mamama1/DL500_Hardware/Frontpanel/R1.0/Frontpanel_Left.stl

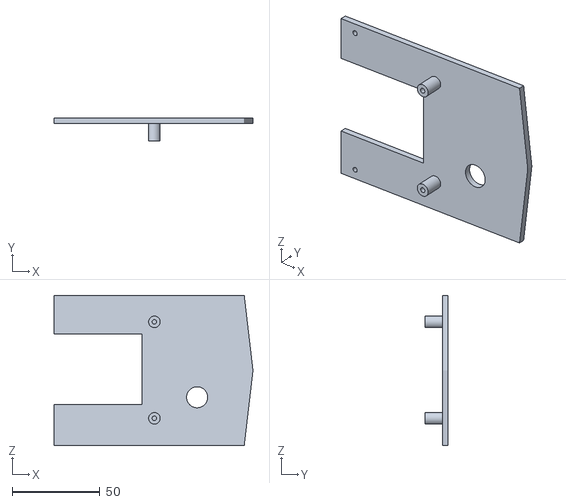
[picture p1: CAD file, 2021-10-21]
Frontpanel/R1.0/Frontpanel_Left.stl
113.5 x 13.0 x 85.6
