mamama1/DL500_Hardware/Frontpanel/R1.1/Frontpanel.stl

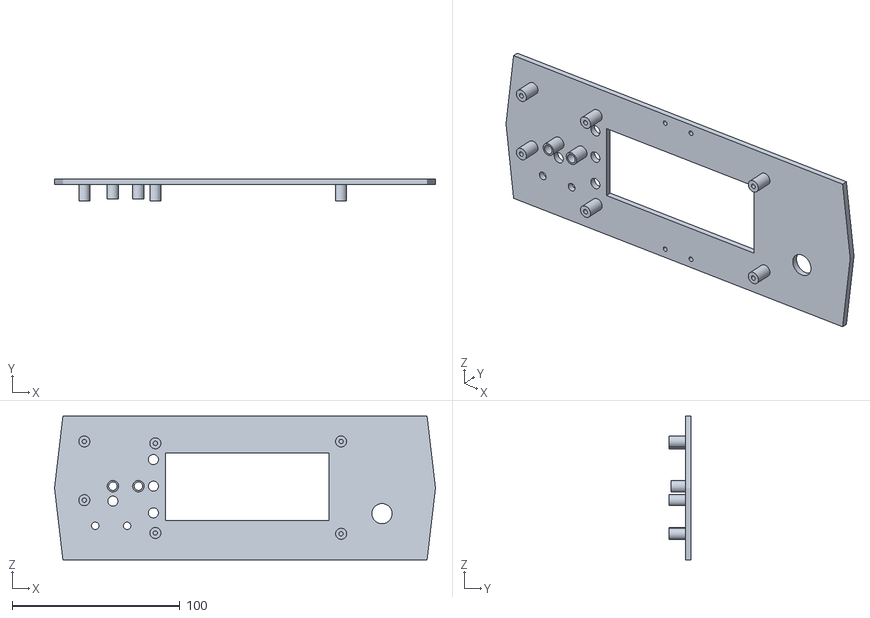
[picture p2: CAD file, 2021-10-21]
Frontpanel/R1.1/Frontpanel.stl
227.0 x 13.0 x 85.6
