mamama1/DL500_Hardware/STL/front_panel_DummyLoad_R1.0_565-6883.stl

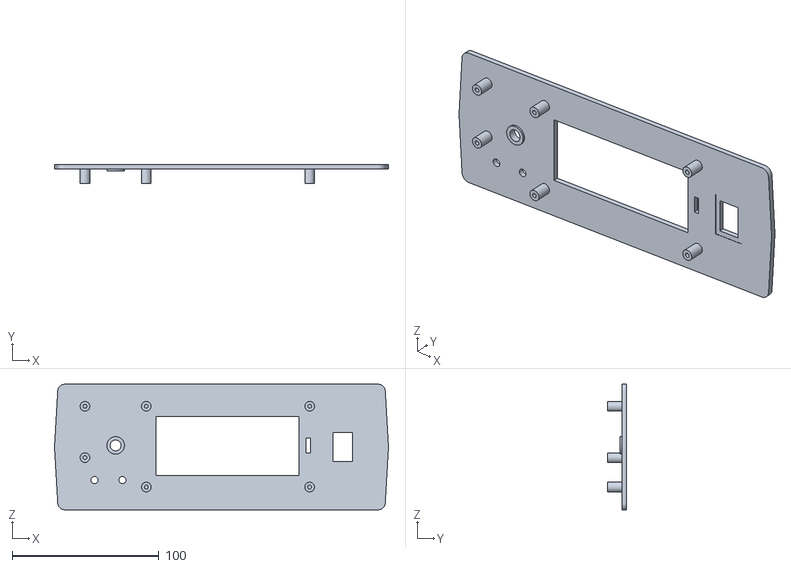
[picture p3: CAD file, 2021-10-21]
STL/front_panel_DummyLoad_R1.0_565-6883.stl
227.4 x 13.0 x 85.6
