mamama1/DL500_Hardware/Frontpanel/R1.1/Frontpanel_Right.stl

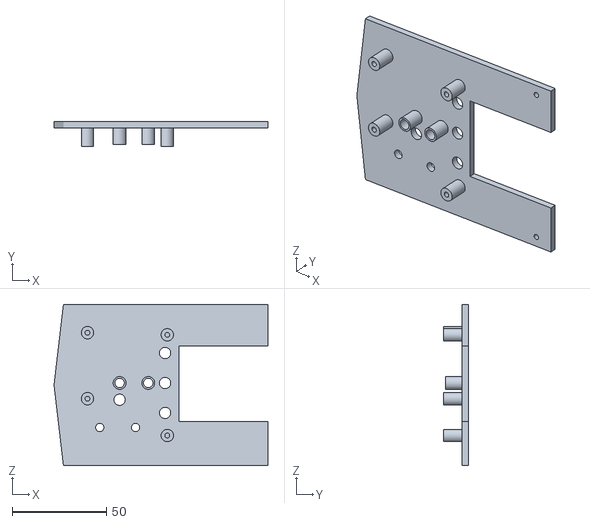
[picture p4: CAD file, 2021-10-21]
Frontpanel/R1.1/Frontpanel_Right.stl
113.5 x 13.0 x 85.6
