mamama1/DL500_Hardware/STL/back_panel_DummyLoad_R1.0.stl

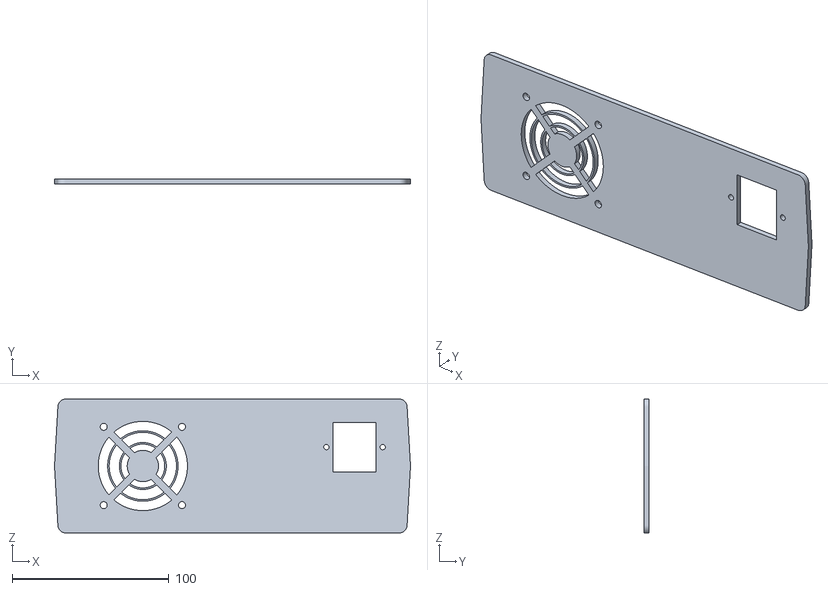
[picture p5: CAD file, 2021-10-21]
STL/back_panel_DummyLoad_R1.0.stl
227.4 x 3.20 x 85.6
