mamama1/DL500_Hardware/DummyLoad.pdf

# 32mA/T

PT 4.5/2/8 | 630 mA/T | DF04M

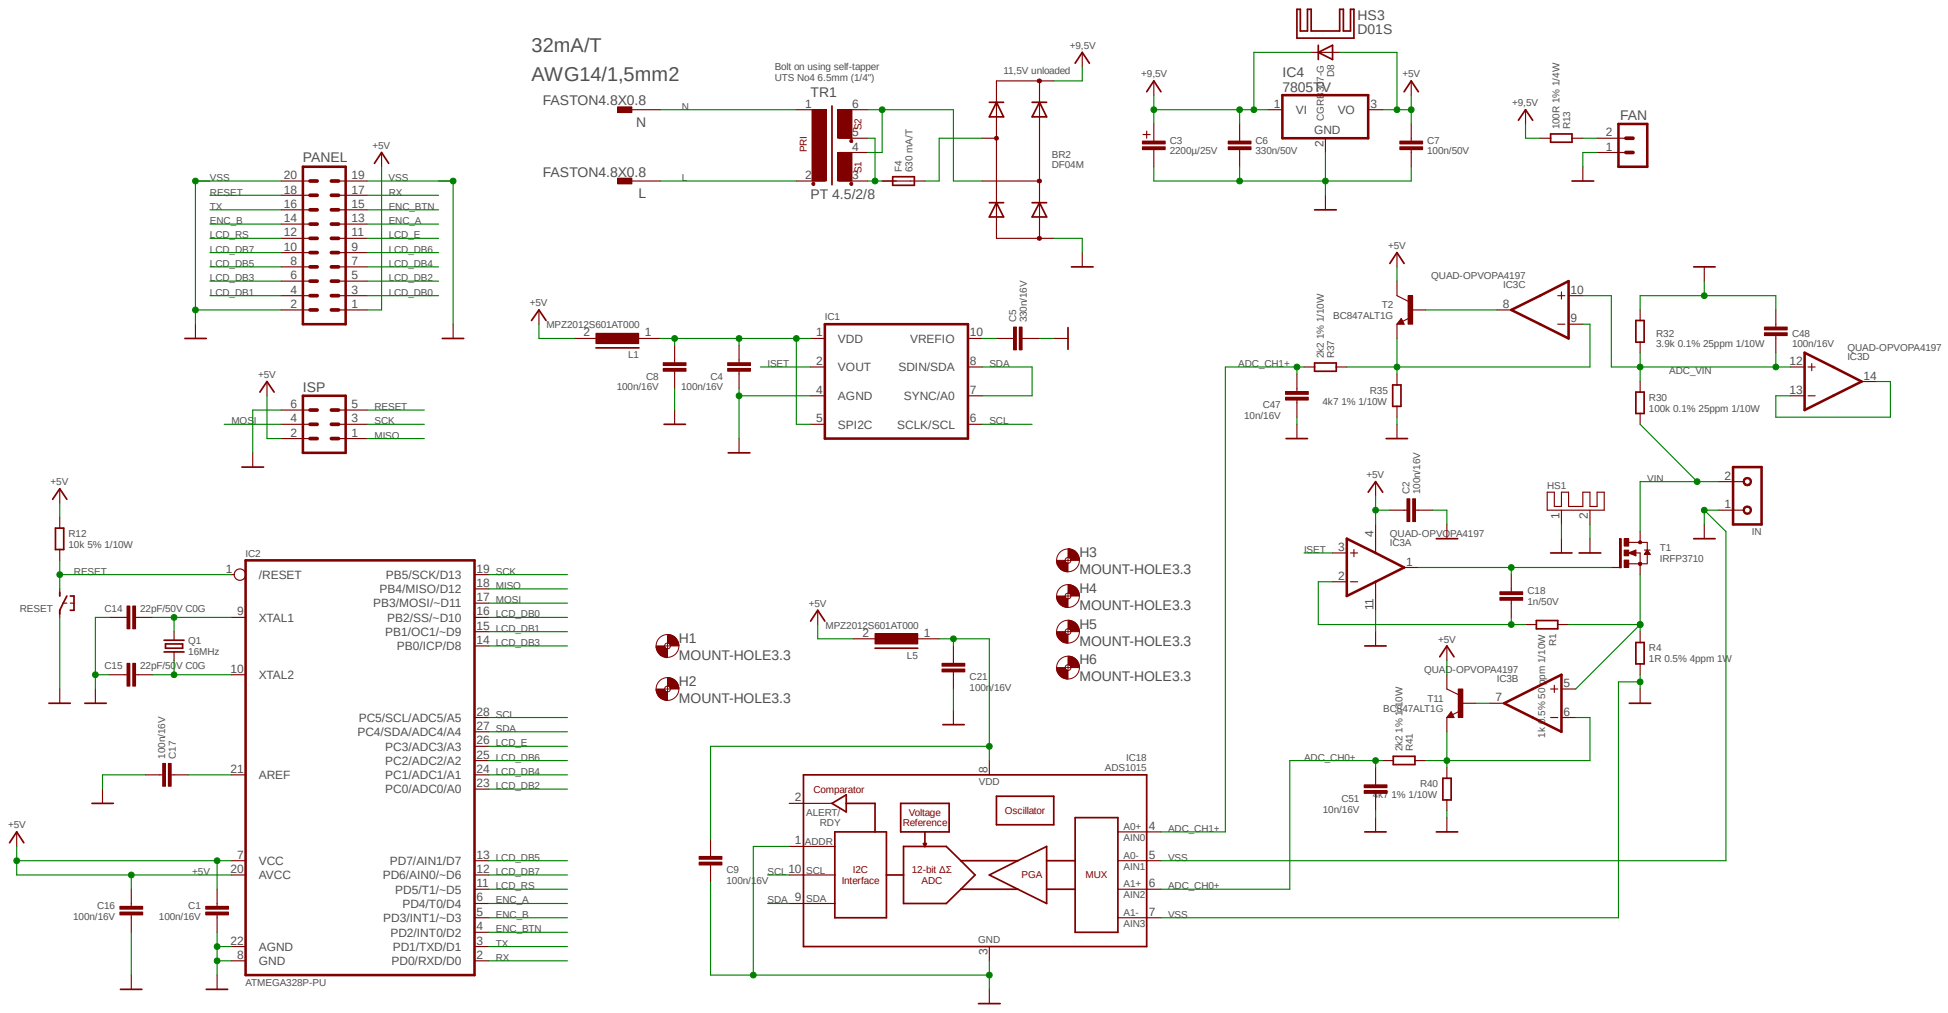
[picture p6: page 1]

Comparator

I2C Interface | AIN0 A0- | 5 VSS
