mamama1/DL500_Hardware/R1.2/DummyLoad.brd

## EAGLE design R1.2/DummyLoad.brd (2021-11-23)

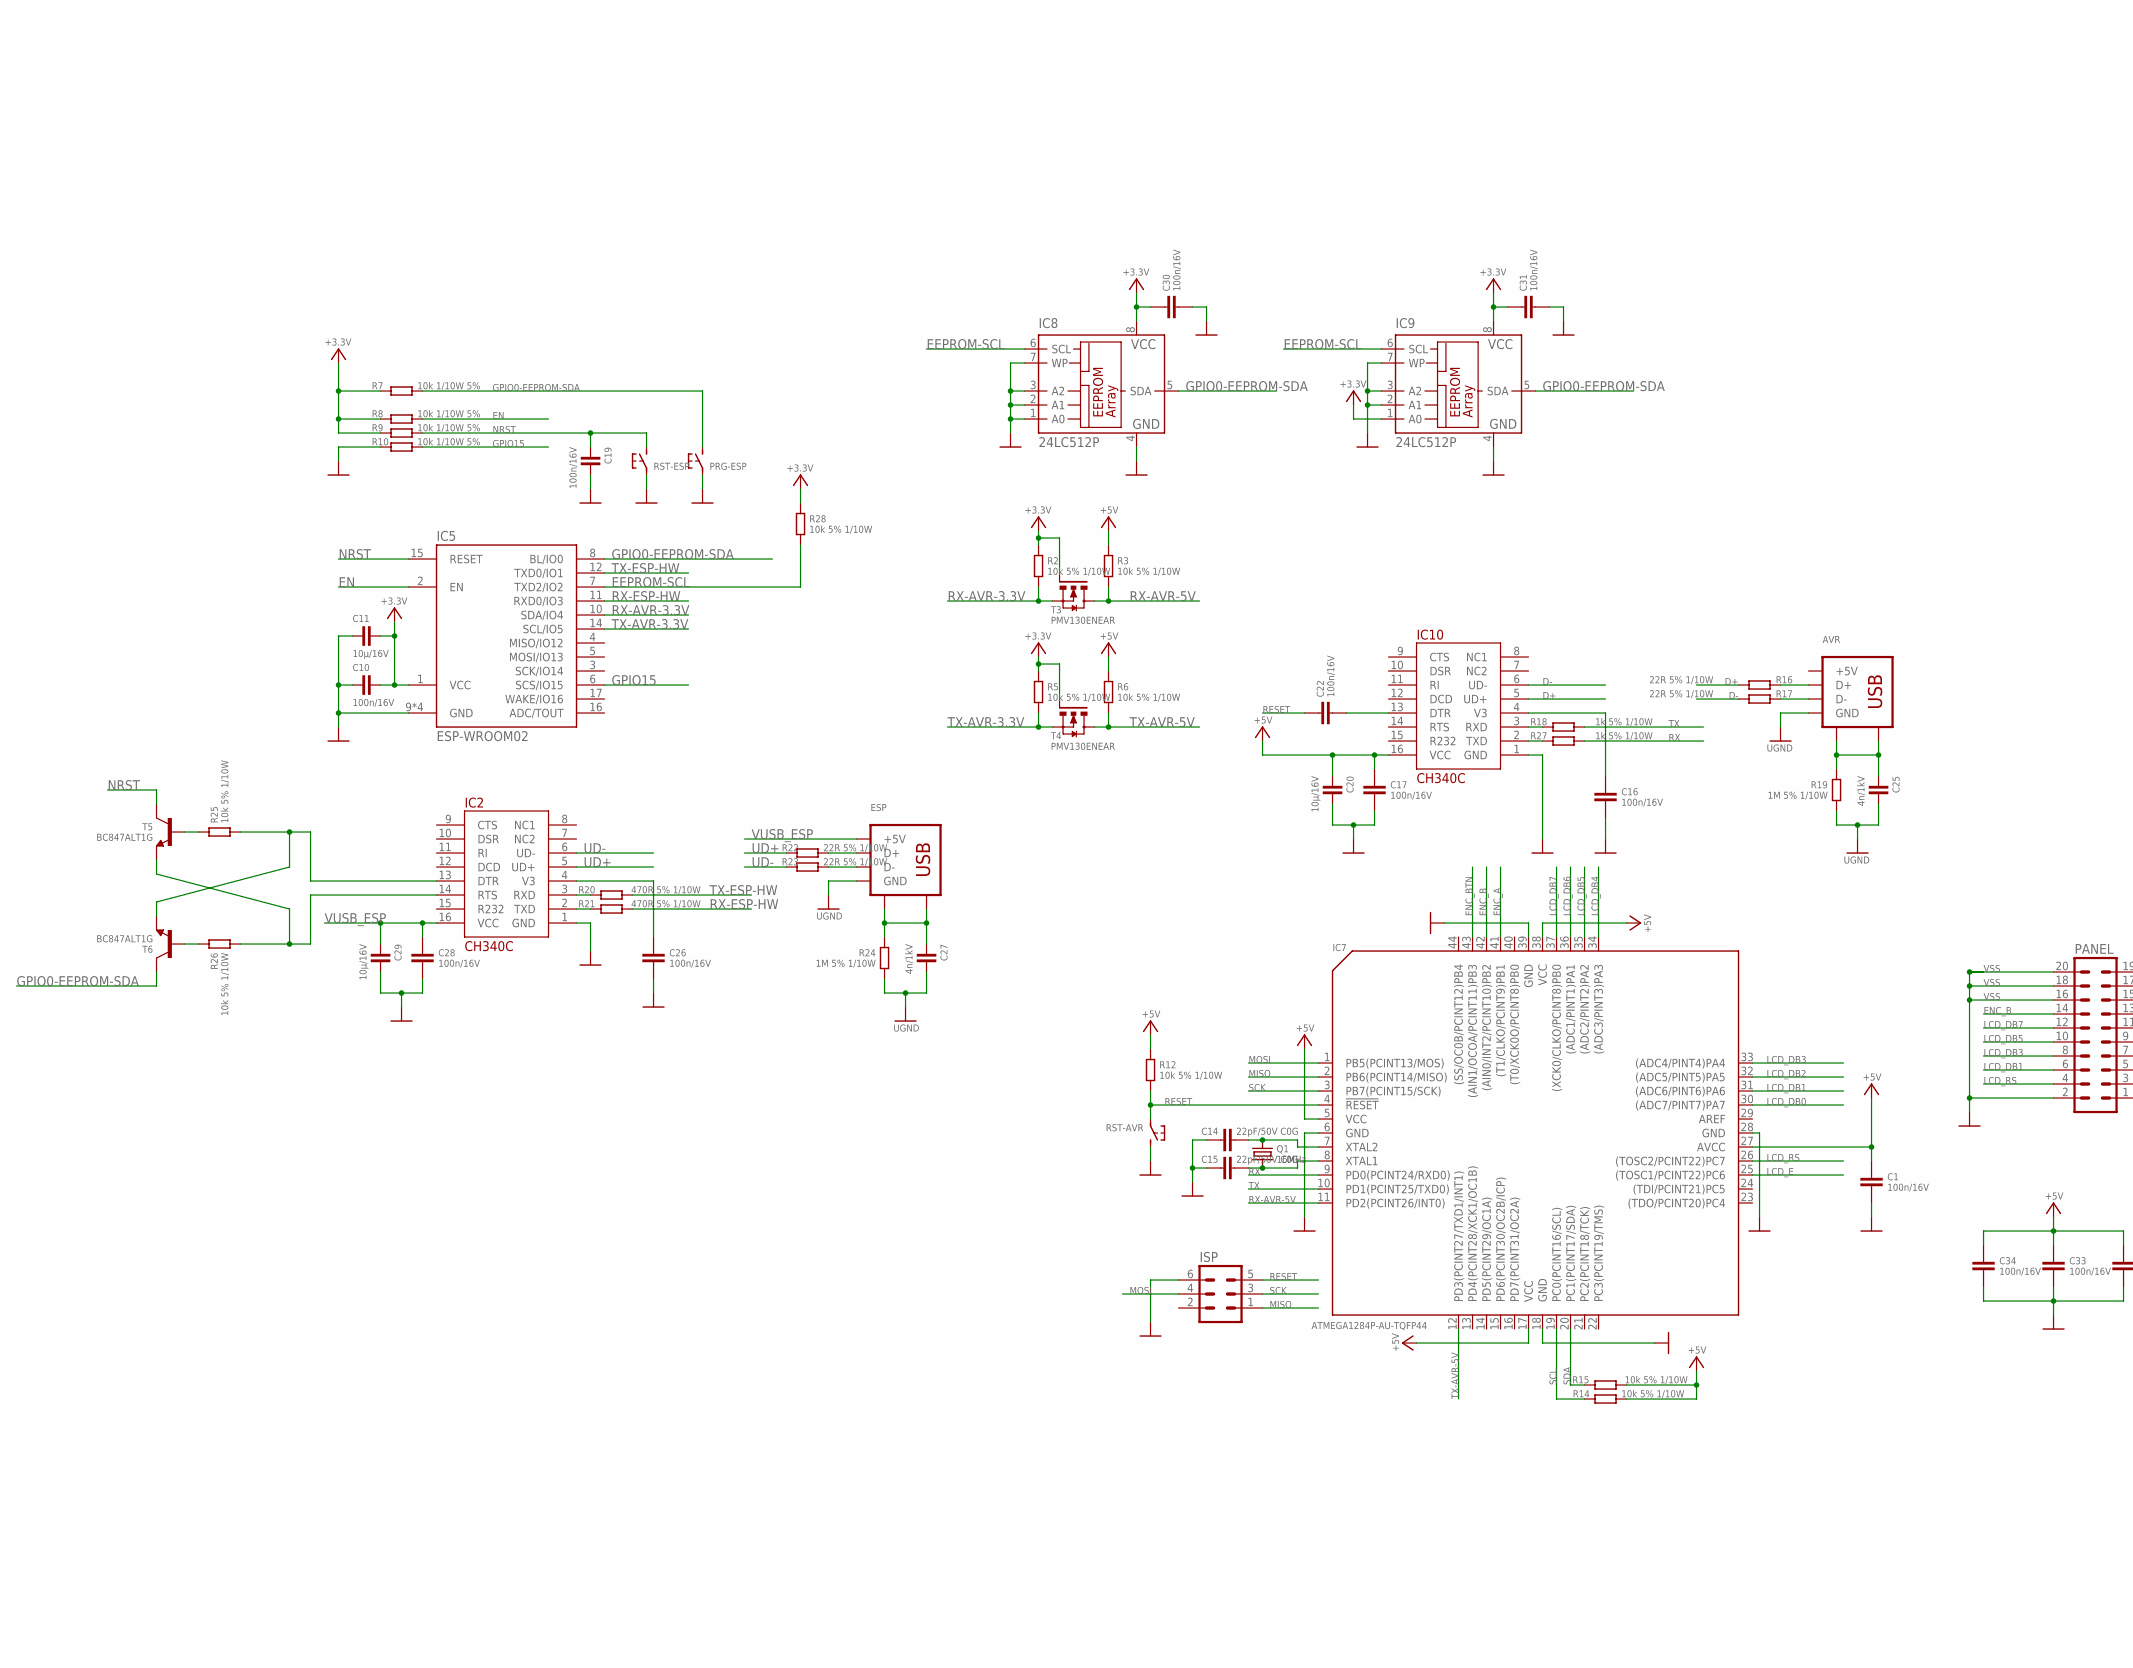
[picture p7: schematic DummyLoad.sch, part in row 1, column 1]

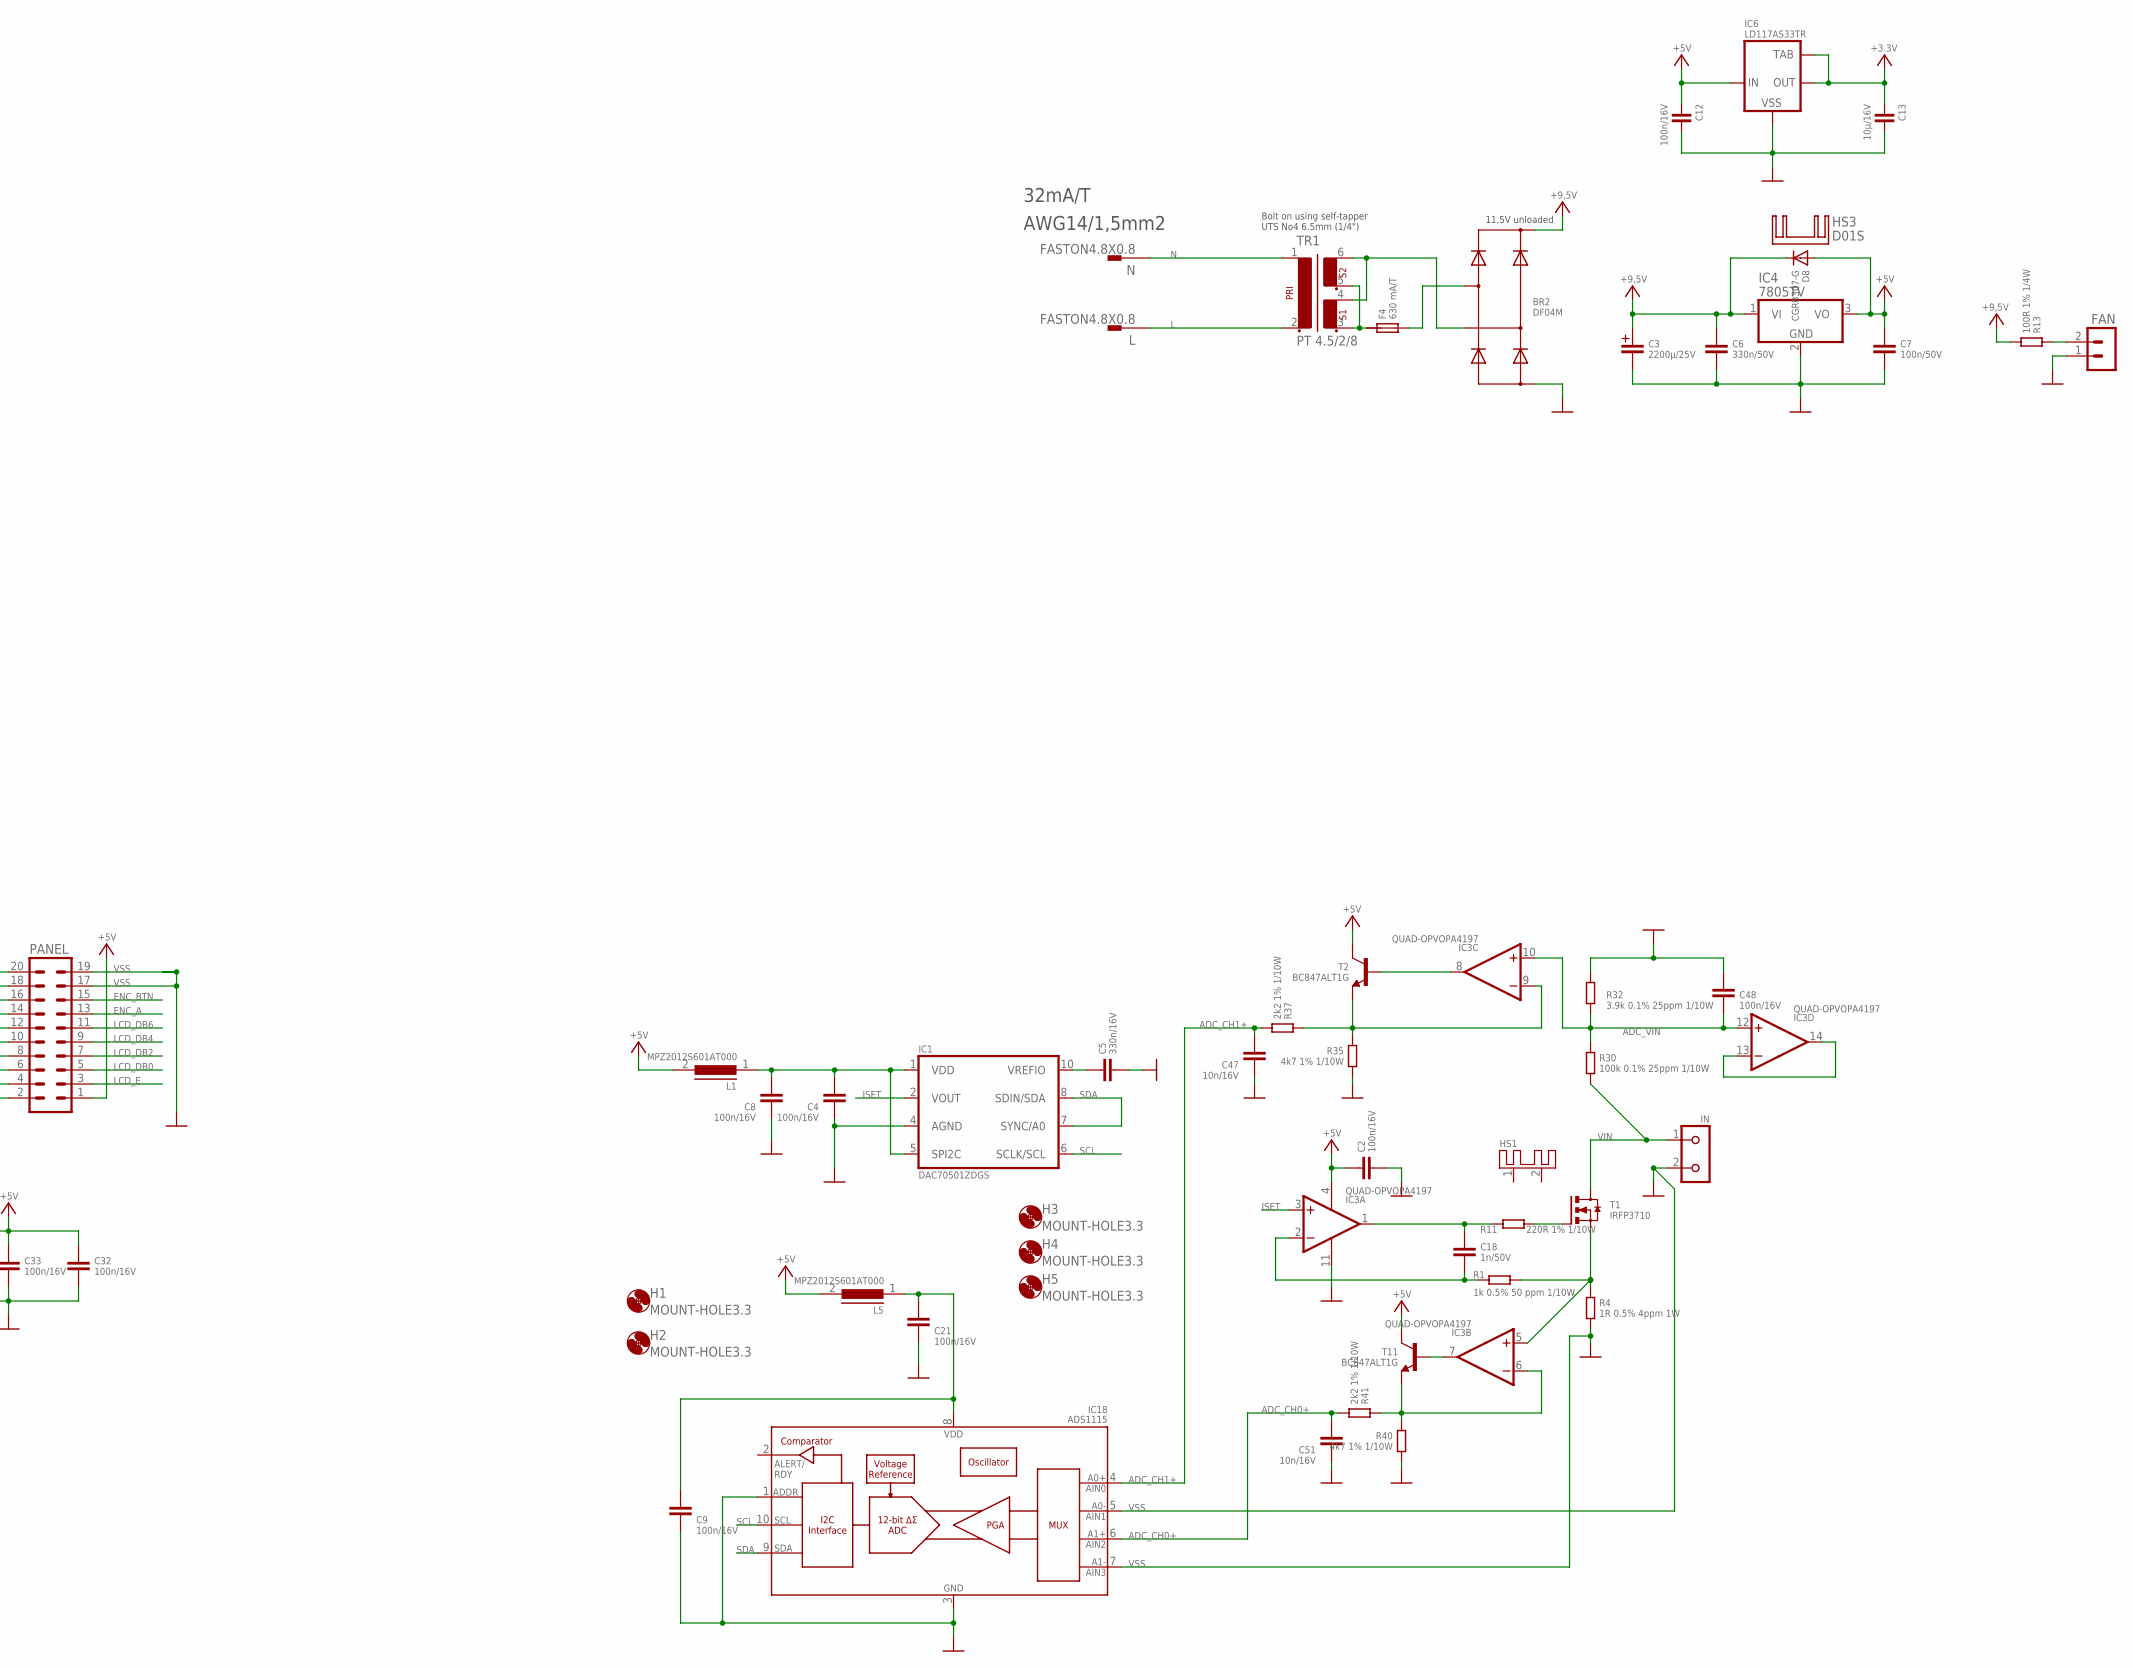
[picture p8: schematic DummyLoad.sch, part in row 1, column 2]

Parts:
AVR: USBUSB-B; USB-B
BR2: DF04M; BR-DIL2
C1, C2, C4, C8, C9, C16, C17, C21, C22, C26, C28, C30, C31, C32, C33, C34, C48: 100n/16V; 0805
C3: 2200µ/25V; C+/5/12.5
C5: 330n/16V; 0805
C6: 330n/50V; 0805
C7: 100n/50V; 0805
C10, C12, C19: 100n/16V; C0805
C11, C13, C20, C29: 10µ/16V; C1210
C14, C15: 22pF/50V C0G; 0805
C18: 1n/50V; 0805
C25, C27: 4n/1kV; C1206
C47, C51: 10n/16V; 0805
D8: CGRB307-G; DO214AA-CGRB307-G
ESP: USBUSB-B; USB-B
F4: 630 mA/T; F5X20
FAN: JST-PH-2.0-2P
H1, H2, H3, H4, H5: MOUNT-HOLE3.3; 3,3
HS1: HSCR201-50; CR201-50
HS3: D01S
IC1: DAC70501ZDGS; VSSOP10
IC2, IC10: CH340C; SOP16
IC3: QUAD-OPVOPA4197; SO14
IC4: 7805TV; TO220V
IC5: ESP-WROOM02
IC6: LD117AS33TR; SOT223
IC7: ATMEGA1284P-AU-TQFP44; TQFP44-0.8-9.6X9.6MM
IC8, IC9: 24LC512P; DIL08
IC18: ADS1115; VSSOP10
IN: KL2691311500002; KL2-691311500002
ISP: ML6
L: FASTON4.8X0.8; FASTON-4.8X0.8
L1, L5: MPZ2012S601AT000; C0805K
N: FASTON4.8X0.8; FASTON-4.8X0.8
PANEL: MA10-2
PRG-ESP: TS1B3F-10XX; B3F-10XX
Q1: 16MHz; Q-5X3.2MM-TXC-7A.SERIES
R1: 1k 0.5% 50 ppm 1/10W; C0805K
R2, R3, R5, R6, R12, R14, R15, R25, R26, R28: 10k 5% 1/10W; C0805K
R4: 1R 0.5% 4ppm 1W; R-SHUNT-VSR
R7, R8, R9, R10: 10k 1/10W 5%; C0805K
R11: 220R 1% 1/10W; C0805K
R13: 100R 1% 1/4W; C0805K
R16, R17, R22, R23: 22R 5% 1/10W; C0805K
R18, R27: 1k 5% 1/10W; C0805K
R19, R24: 1M 5% 1/10W; C0805K
R20, R21: 470R 5% 1/10W; C0805K
R30: 100k 0.1% 25ppm 1/10W; C0805K
R32: 3.9k 0.1% 25ppm 1/10W; C0805K
R35, R40: 4k7 1% 1/10W; C0805K
R37, R41: 2k2 1% 1/10W; C0805K
RST-AVR: TS1B3F-10XX; B3F-10XX
RST-ESP: TS1B3F-10XX; B3F-10XX
T1: IRFP3710; TOP3AV
T2, T5, T6, T11: BC847ALT1G; SOT23-BEC
T3, T4: PMV130ENEAR; SOT23
TR1: PT 4.5/2/8; PT/4,5/2/..

Connections:
+3.3V: C10.2, C11.2, C13.1, C30.1, C31.1, IC5.1 (VCC), IC6.2 (OUT), IC6.4 (OUT1), IC8.8 (VCC), IC9.1 (A0), IC9.8 (VCC), R2.1, R5.1, R7.1, R8.1, R9.1, R28.1, T3.1 (G), T4.1 (G)
+5V: C1.1, C2.1, C7.1, C12.1, C17.1, C20.1, C32.1, C33.1, C34.1, D8.A, IC3.4 (V+), IC4.3 (VO), IC6.3 (IN), IC7.5 (VCC), IC7.17 (VCC), IC7.27 (AVCC), IC7.38 (VCC), IC10.16 (VCC), L1.2, L5.2, PANEL.1, R3.1, R6.1, R12.1, R14.2, R15.2, T2.C, T11.C
+9,5V: BR2.DC+, C3.+, C6.1, D8.C, IC4.1 (VI), R13.2
ADC_CH0+: C51.1, IC18.6 (AIN2), R41.2
ADC_CH1+: C47.1, IC18.4 (AIN0), R37.2
ADC_VIN: C48.2, IC3.10 (+IN), IC3.12 (+IN), R30.1, R32.2
D+: IC10.5 (UD+), R16.1
D-: IC10.6 (UD-), R17.1
EEPROM-SCL: IC5.7 (TXD2/IO2), IC8.6 (SCL), IC9.6 (SCL), R28.2
EN: IC5.2 (EN), R8.2
ENC_A: IC7.41 ((T1/CLKO/PCINT9)PB1), PANEL.13
ENC_B: IC7.42 ((AIN0/INT2/PCINT10)PB2), PANEL.14
ENC_BTN: IC7.43 ((AIN1/OCOA/PCINT11)PB3), PANEL.15
GPIO0-EEPROM-SDA: IC5.8 (BL/IO0), IC8.5 (SDA), IC9.5 (SDA), PRG-ESP.3 (2), R7.2, T6.C
GPIO15: IC5.6 (SCS/IO15), R10.2
ISET: IC1.2 (VOUT), IC3.3 (+IN)
L: L.A1, L.A2, TR1.2
LCD_DB0: IC7.30 ((ADC7/PINT7)PA7), PANEL.5
LCD_DB1: IC7.31 ((ADC6/PINT6)PA6), PANEL.6
LCD_DB2: IC7.32 ((ADC5/PINT5)PA5), PANEL.7
LCD_DB3: IC7.33 ((ADC4/PINT4)PA4), PANEL.8
LCD_DB4: IC7.34 ((ADC3/PINT3)PA3), PANEL.9
LCD_DB5: IC7.35 ((ADC2/PINT2)PA2), PANEL.10
LCD_DB6: IC7.36 ((ADC1/PINT1)PA1), PANEL.11
LCD_DB7: IC7.37 ((XCK0/CLKO/PCINT8)PB0), PANEL.12
LCD_E: IC7.25 ((TOSC1/PCINT22)PC6), PANEL.3
LCD_RS: IC7.26 ((TOSC2/PCINT22)PC7), PANEL.4
MISO: IC7.2 (PB6(PCINT14/MISO)), ISP.1
MOSI: IC7.1 (PB5(PCINT13/MOS)), ISP.4
N: N.A1, N.A2, TR1.1
unnamed: C18.1, IC3.1 (OUT), R11.1
unnamed: IC3.7 (OUT), T11.B
unnamed: C16.1, IC10.4 (V3)
unnamed: C18.2, IC3.2 (-IN), R1.2
unnamed: IC3.5 (+IN), R1.1, R4.1, T1.E (S)
unnamed: C9.1, C21.1, IC18.8 (VDD), L5.1
unnamed: C5.1, IC1.10 (VREFIO)
unnamed: IC3.8 (OUT), T2.B
unnamed: IC3.13 (-IN), IC3.14 (OUT)
unnamed: AVR.D+, R16.2
unnamed: AVR.D-, R17.2
unnamed: R11.2, T1.B (G)
unnamed: IC10.3 (RXD), R18.1
unnamed: C14.2, IC7.7 (XTAL2), Q1.2
unnamed: C15.2, IC7.8 (XTAL1), Q1.1
unnamed: IC10.2 (TXD), R27.1
unnamed: AVR.SH1, AVR.SH2, C25.1, R19.1
unnamed: C26.1, IC2.4 (V3)
unnamed: IC2.3 (RXD), R20.1
unnamed: IC2.2 (TXD), R21.1
unnamed: ESP.D+, R22.2
unnamed: ESP.D-, R23.2
unnamed: C27.1, ESP.SH1, ESP.SH2, R24.1
unnamed: R25.1, T5.B
unnamed: R26.1, T6.B
unnamed: C22.2, IC10.13 (DTR)
unnamed: BR2.AC1, F4.3 (2), F4.4 (2)
unnamed: IC2.14 (RTS), R26.2, T5.E
unnamed: IC2.13 (DTR), R25.2, T6.E
unnamed: F4.1, F4.2 (1), TR1.3, TR1.5
unnamed: BR2.AC2, TR1.4, TR1.6
unnamed: FAN.2, R13.1
unnamed: IC3.9 (-IN), R35.1, R37.1, T2.E
unnamed: IC3.6 (-IN), R40.1, R41.1, T11.E
NRST: C19.1, IC5.15 (RESET), R9.2, RST-ESP.3 (2), T5.C
RESET: C22.1, IC7.4 (!RESET), ISP.5, R12.2, RST-AVR.1
RX: IC7.9 (PD0(PCINT24/RXD0)), R27.2
RX-AVR-3.3V: IC5.10 (SDA/IO4), R2.2, T3.2 (S)
RX-AVR-5V: IC7.11 (PD2(PCINT26/INT0)), R3.2, T3.3 (D)
RX-ESP-HW: IC5.11 (RXD0/IO3), R21.2
SCK: IC7.3 (PB7(PCINT15/SCK)), ISP.3
SCL: IC1.6 (SCLK/SCL), IC7.19 (PC0(PCINT16/SCL)), IC18.10 (SCL), R14.1
SDA: IC1.7 (SYNC/A0), IC1.8 (SDIN/SDA), IC7.20 (PC1(PCINT17/SDA)), IC18.9 (SDA), R15.1
TX: IC7.10 (PD1(PCINT25/TXD0)), R18.2
TX-AVR-3.3V: IC5.14 (SCL/IO5), R5.2, T4.2 (S)
TX-AVR-5V: IC7.12 (PD3(PCINT27/TXD1/INT1)), R6.2, T4.3 (D)
TX-ESP-HW: IC5.12 (TXD0/IO1), R20.2
UD+: IC2.5 (UD+), R22.1
UD-: IC2.6 (UD-), R23.1
UGND: AVR.GND, C25.2, C27.2, ESP.GND, R19.2, R24.2
VDD: C4.1, C8.1, IC1.1 (VDD), IC1.5 (SPI2C), L1.1
VIN: IN.1, R30.2, T1.C (D)
VSS: BR2.DC-, C1.2, C2.2, C3.-, C4.2, C5.2, C6.2, C7.2, C8.2, C9.2, C10.1, C11.1, C12.2, C13.2, C14.1, C15.1, C16.2, C17.2, C19.2, C20.2, C21.2, C26.2, C28.2, C29.2, C30.2, C31.2, C32.2, C33.2, C34.2, C47.2, C48.1, C51.2, FAN.1, IC1.4 (AGND), IC2.1 (GND), IC3.11 (V-), IC4.2 (GND), IC5.9 (GND), IC5.13 (GND), IC5.18 (GND), IC5.TP (GND), IC6.1 (VSS), IC7.6 (GND), IC7.18 (GND), IC7.28 (GND), IC7.39 (GND), IC8.1 (A0), IC8.2 (A1), IC8.3 (A2), IC8.4 (GND), IC8.7 (WP), IC9.2 (A1), IC9.3 (A2), IC9.4 (GND), IC9.7 (WP), IC10.1 (GND), IC18.1 (ADDR), IC18.3 (VSS), IC18.5 (AIN1), IC18.7 (AIN3), IN.2, ISP.6, PANEL.2, PANEL.16, PANEL.17, PANEL.18, PANEL.19, PANEL.20, PRG-ESP.1, R4.2, R10.1, R32.1, R35.2, R40.2, RST-AVR.3 (2), RST-ESP.1
VUSB_ESP: C28.1, C29.1, ESP.+5V, IC2.16 (VCC)

Notes on the sheet:
11,5V unloaded
AWG14/1,5mm2
32mA/T
Bolt on using self-tapper UTS No4 6.5mm (1/4")

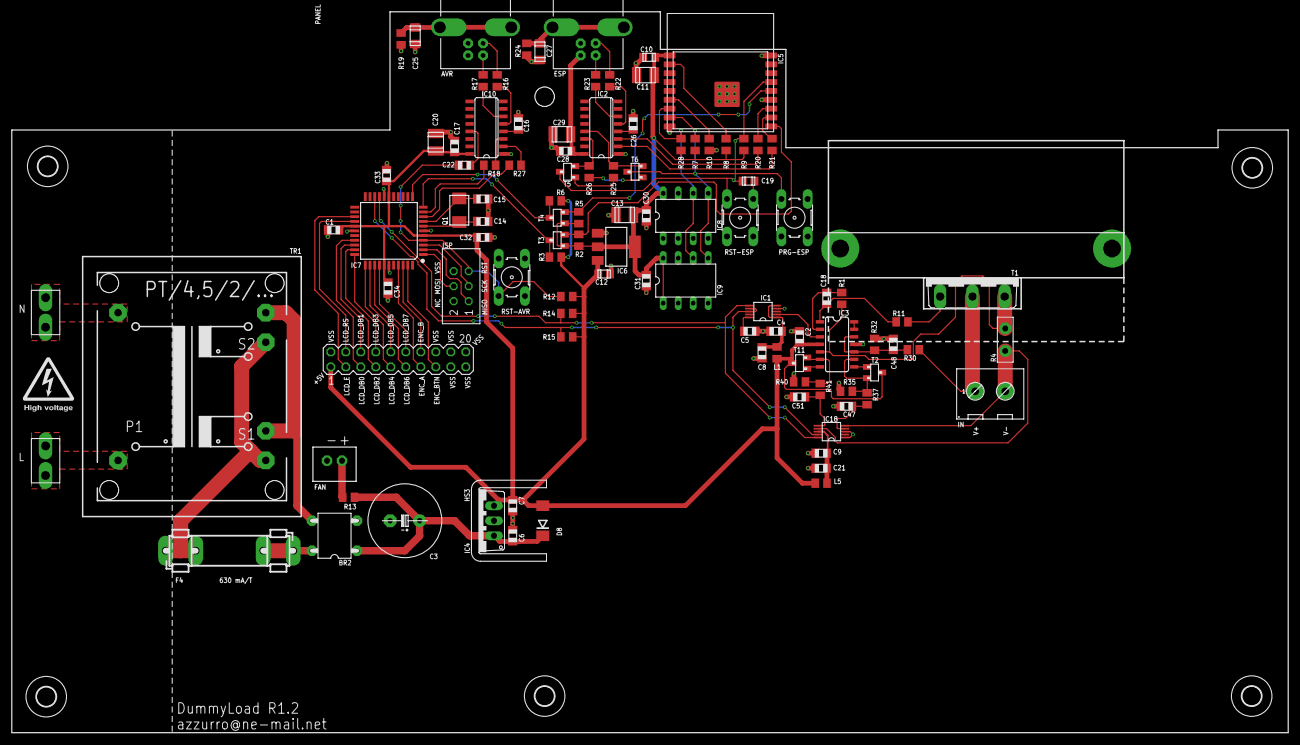
[picture p9: board DummyLoad.brd from above]

Board: 2 copper layers, 216.0 x 122.0 mm, 116 parts (0 on the bottom side), 84 nets.

Other parts of the board:
U$1: CASE-Z17
U$2: IEC-C14-FUSED-6200.2200
U$3: FAN60X25
U$4: SWITCH-ROCKER-1858.1103
