mamama1/DL500_Hardware/Frontpanel/R1.0/DummyLoad_Frontpanel.brd

## EAGLE design Frontpanel/R1.0/DummyLoad_Frontpanel.brd (2021-10-21)

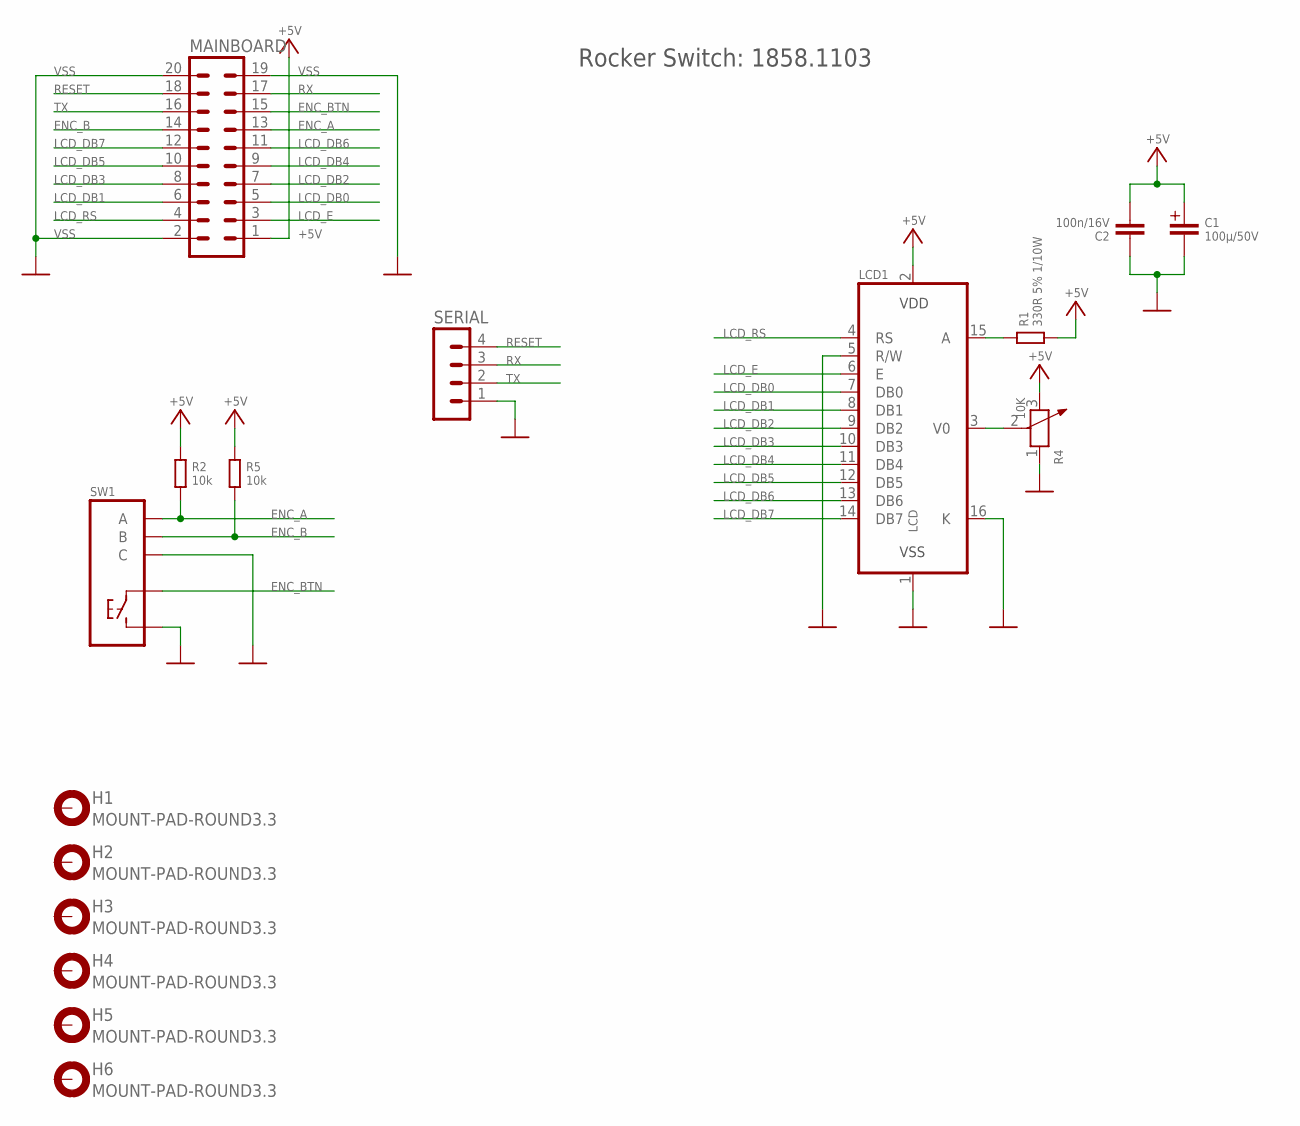
[picture p10: schematic DummyLoad_Frontpanel.sch]

Parts:
C1: 100µ/50V; C+/3.5/8
C2: 100n/16V; 0805
H1, H2, H3, H4, H5, H6: MOUNT-PAD-ROUND3.3; 3,3-PAD
LCD1: LCD; DISPLAYTECH-204C
MAINBOARD: MA10-2
R1: 330R 5% 1/10W; C0805K
R2, R5: 10k; C0805K
R4: 10K; ADJR3-7.0X7.0X5.0MM
SERIAL: MA04-1
SW1: EC12E-SW

Connections:
+5V: C1.+, C2.2, LCD1.2 (VDD), MAINBOARD.1, R1.2, R2.1, R4.3, R5.1
ENC_A: MAINBOARD.13, R2.2, SW1.A
ENC_B: MAINBOARD.14, R5.2, SW1.B
ENC_BTN: MAINBOARD.15, SW1.1
LCD_DB0: LCD1.7 (DB0), MAINBOARD.5
LCD_DB1: LCD1.8 (DB1), MAINBOARD.6
LCD_DB2: LCD1.9 (DB2), MAINBOARD.7
LCD_DB3: LCD1.10 (DB3), MAINBOARD.8
LCD_DB4: LCD1.11 (DB4), MAINBOARD.9
LCD_DB5: LCD1.12 (DB5), MAINBOARD.10
LCD_DB6: LCD1.13 (DB6), MAINBOARD.11
LCD_DB7: LCD1.14 (DB7), MAINBOARD.12
LCD_E: LCD1.6 (E), MAINBOARD.3
LCD_RS: LCD1.4 (RS), MAINBOARD.4
unnamed: LCD1.3 (V0), R4.2
unnamed: LCD1.15 (A), R1.1
RESET: MAINBOARD.18, SERIAL.4
RX: MAINBOARD.17, SERIAL.3
TX: MAINBOARD.16, SERIAL.2
VSS: C1.-, C2.1, LCD1.1 (VSS), LCD1.5 (R/W), LCD1.16 (K), MAINBOARD.2, MAINBOARD.19, MAINBOARD.20, R4.1, SERIAL.1, SW1.2, SW1.C

Notes on the sheet:
Rocker Switch: 1858.1103

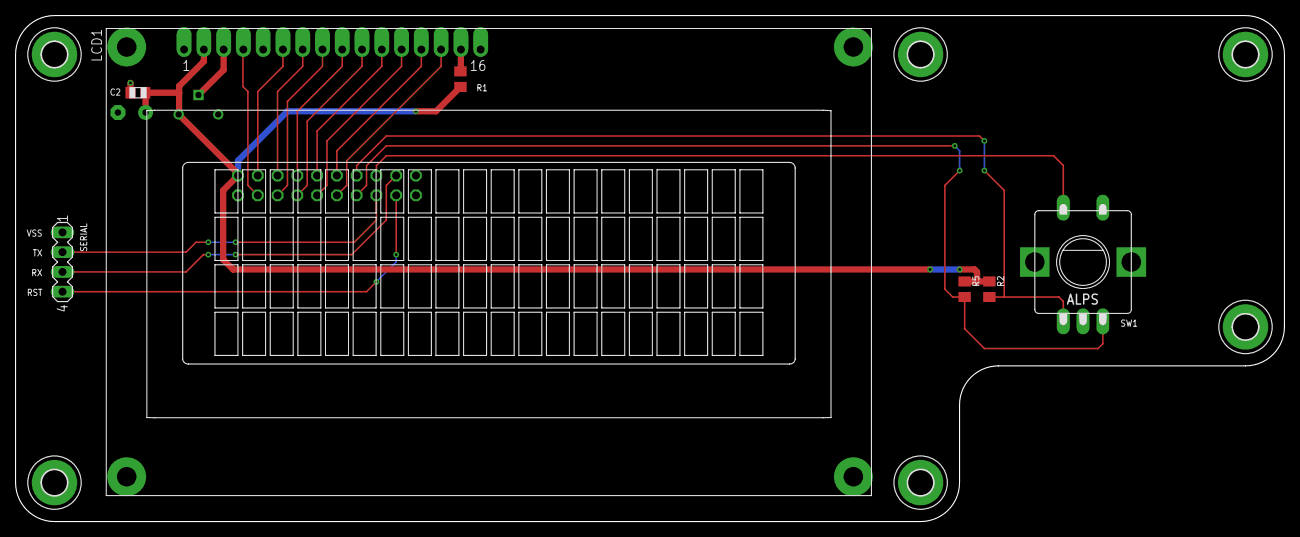
[picture p11: board DummyLoad_Frontpanel.brd from above]

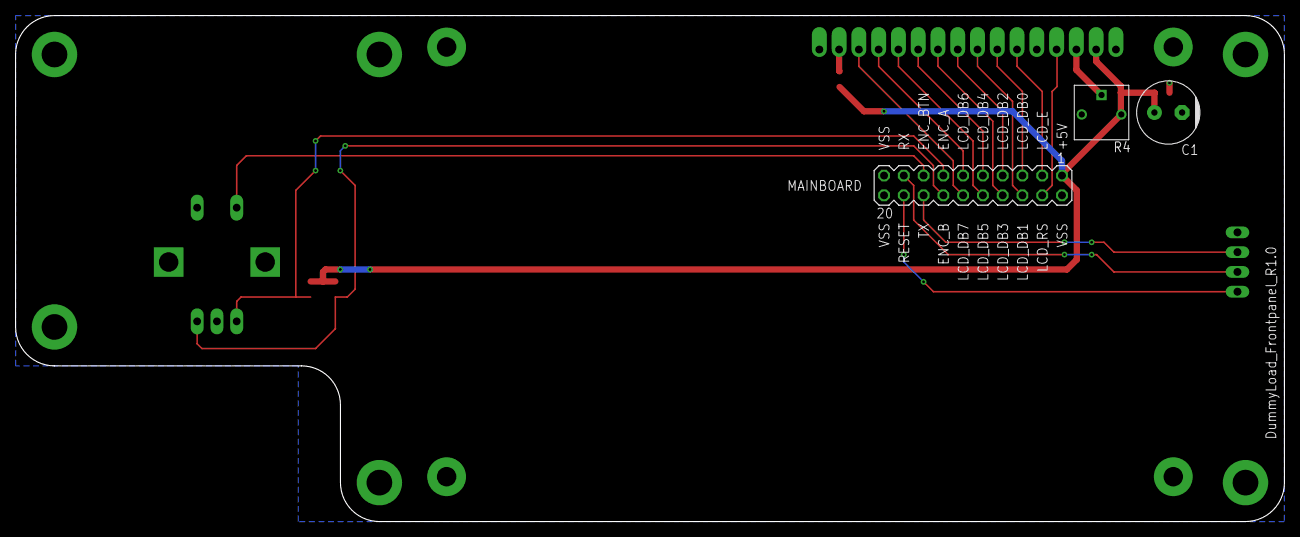
[picture p12: board DummyLoad_Frontpanel.brd from below]

Board: 2 copper layers, 163.0 x 65.0 mm, 16 parts (3 on the bottom side), 20 nets.
